jecor/JIXClock/Hardware/1.0rev1/bugs/figure2.jpg

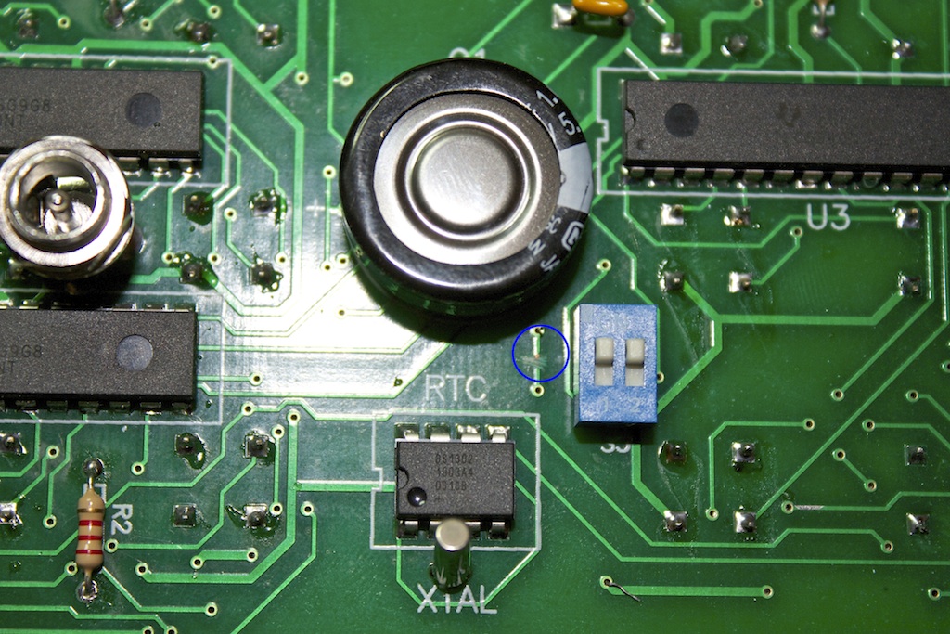
Hardware/1.0rev1/bugs/figure2.jpg
