jecor/JIXClock/Hardware/1.0rev1/bugs/figure3.jpg

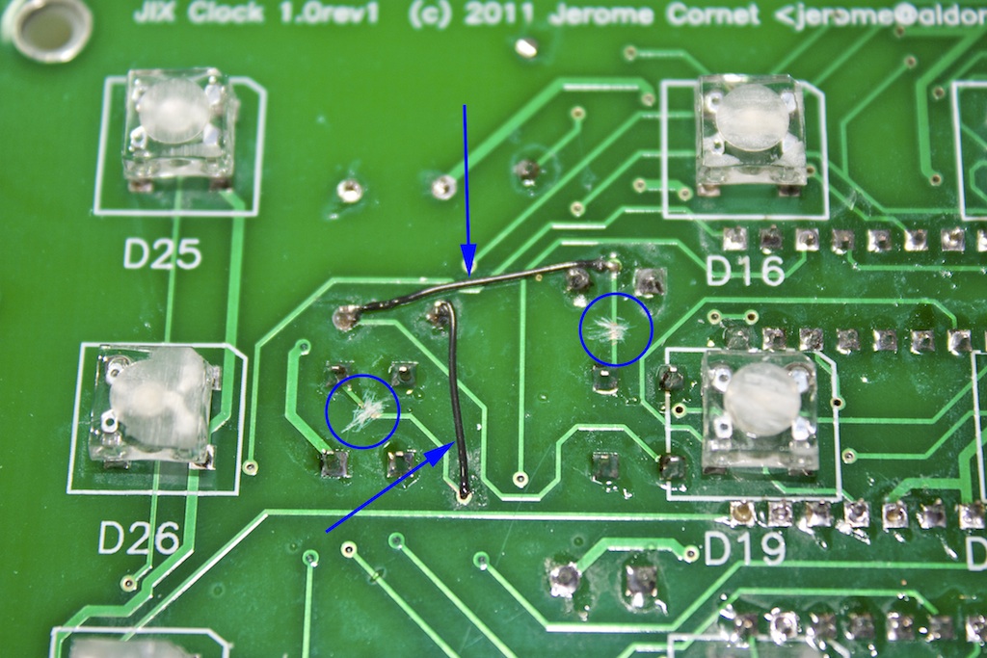
Hardware/1.0rev1/bugs/figure3.jpg
