jecor/JIXClock/README.md

JIXClock
===========

Advanced recreation of the TIX Clock with RGB LEDs, persistent hour and settings, etc.

LICENSE
--------------

* Hardware, Docs and Box under CC-BY-SA.
* Software under GPL v3.

Copyright 2010-2013 Jerome Cornet.
