jecor/JIXClock/Doc/UserGuideFR.pages/QuickLook/Thumbnail.jpg

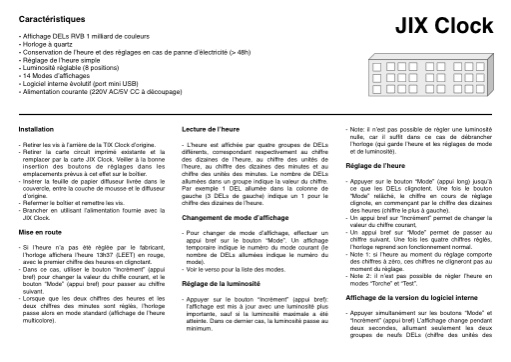
Doc/UserGuideFR.pages/QuickLook/Thumbnail.jpg
