jecor/JIXClock/Hardware/1.0rev1/bugs/figure1.jpg

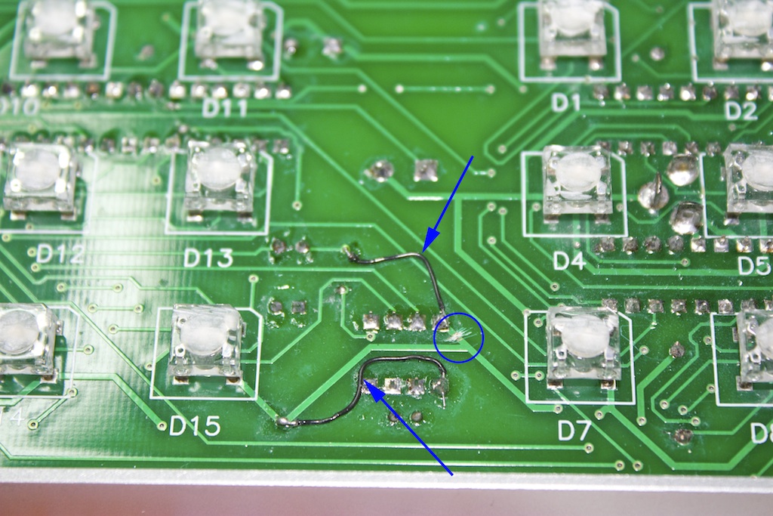
Hardware/1.0rev1/bugs/figure1.jpg
