jecor/JIXClock/Hardware/1.0rev1/schematic/JIXClock.pdf

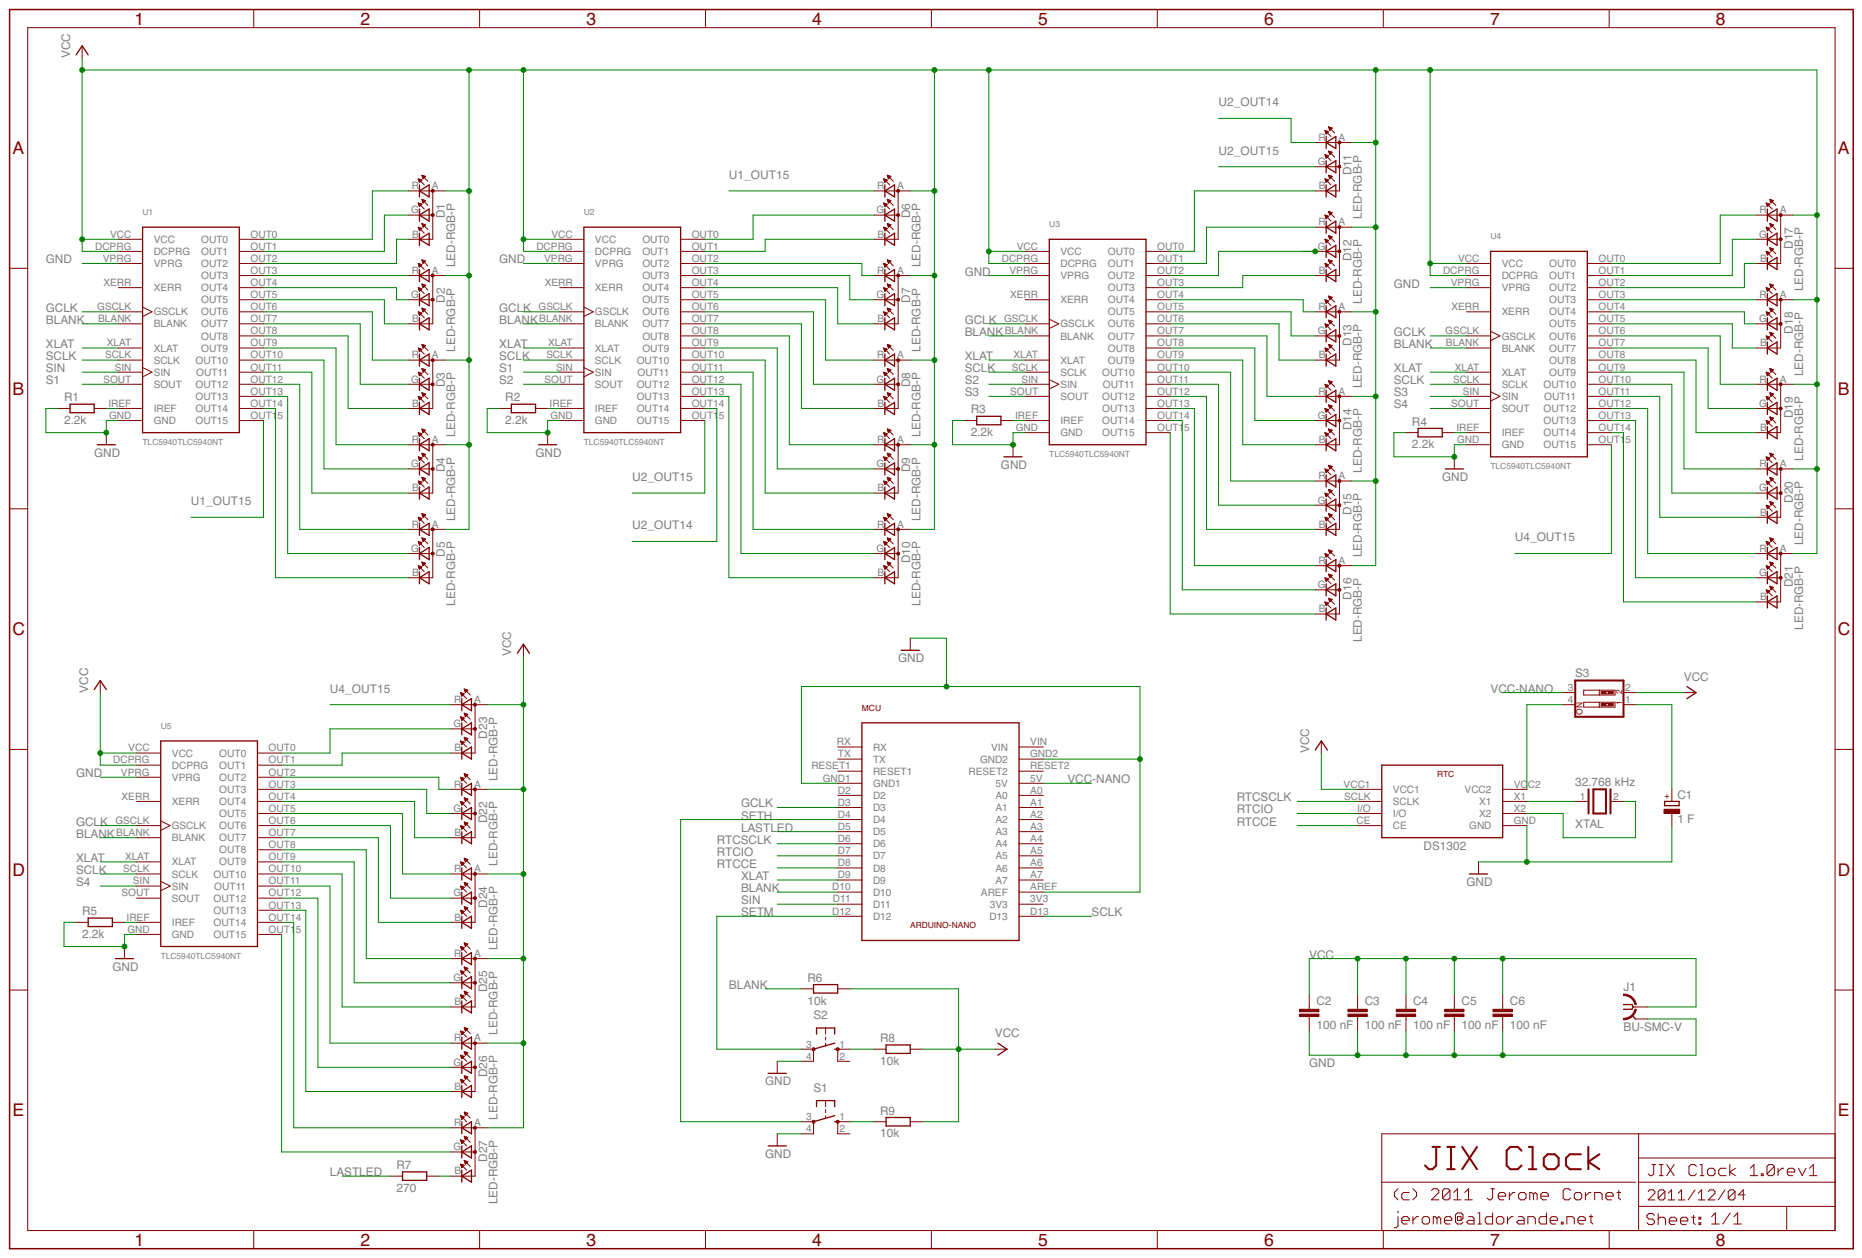
[picture p5: page 1]

LED-RGB-P LED-RGB-P LED-RGB-P

LED-RGB-P LED-RGB-P LED-RGB-P LED-RGB-P LED-RGB-P
