jecor/JIXClock/Box/JIXClockBox-logo.pdf

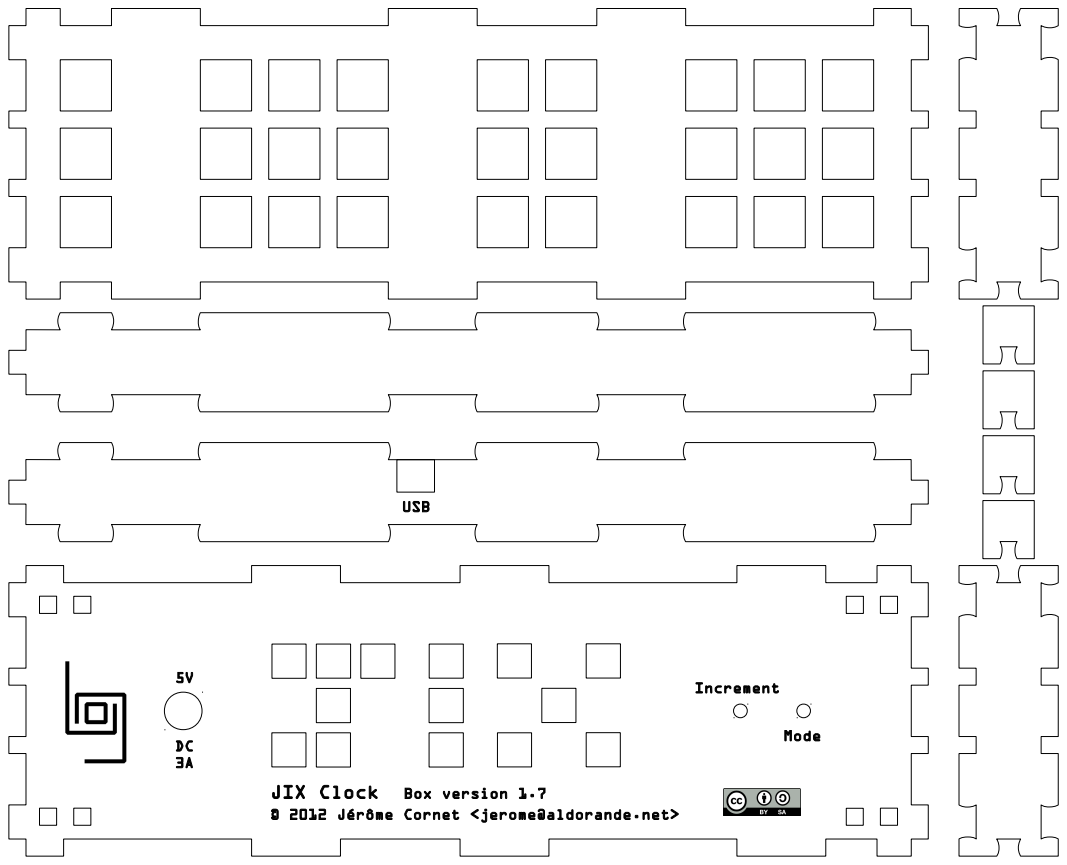
[picture p6: page 1]
JIX Clock; Box version 1.7; Mode; Increment 5V; USB

© 2012 Jérôme Cornet <jerome@aldorande.net>
