jecor/JIXClock/Hardware/1.0rev1/pcb/JIXClockBottom.pdf

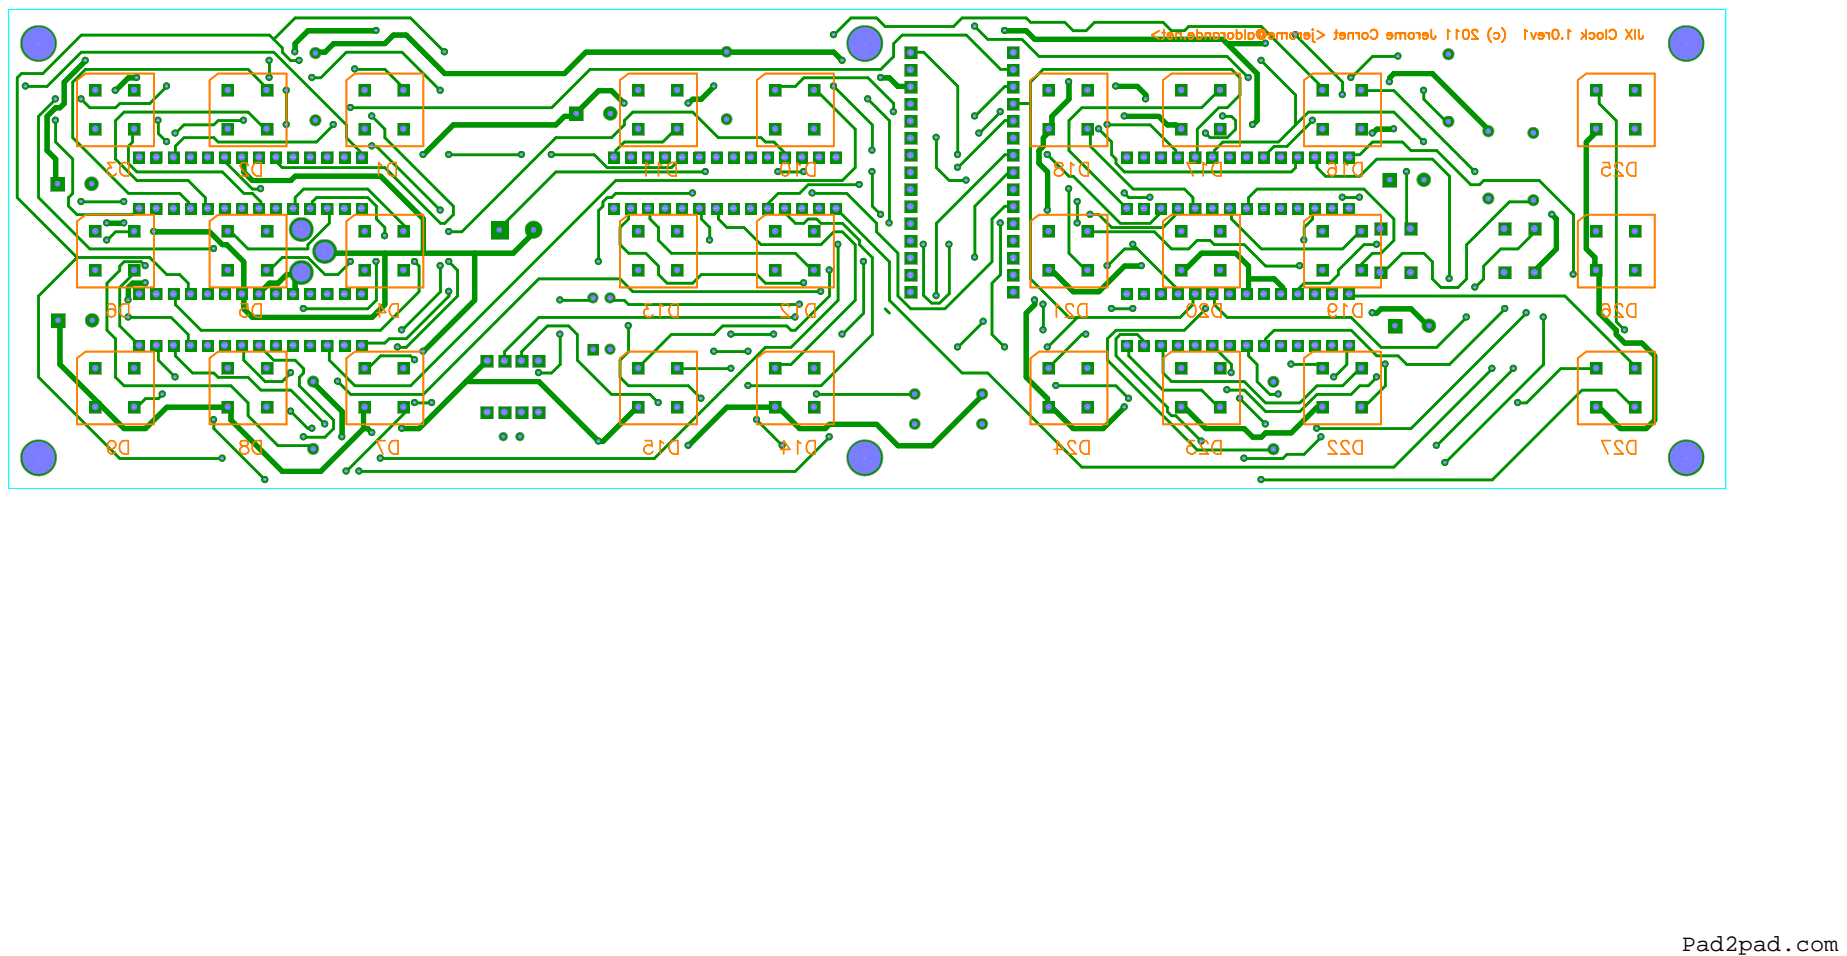
[picture p8: page 1]
