jecor/JIXClock/Hardware/1.0rev1/pcb/JIXClockTop.pdf

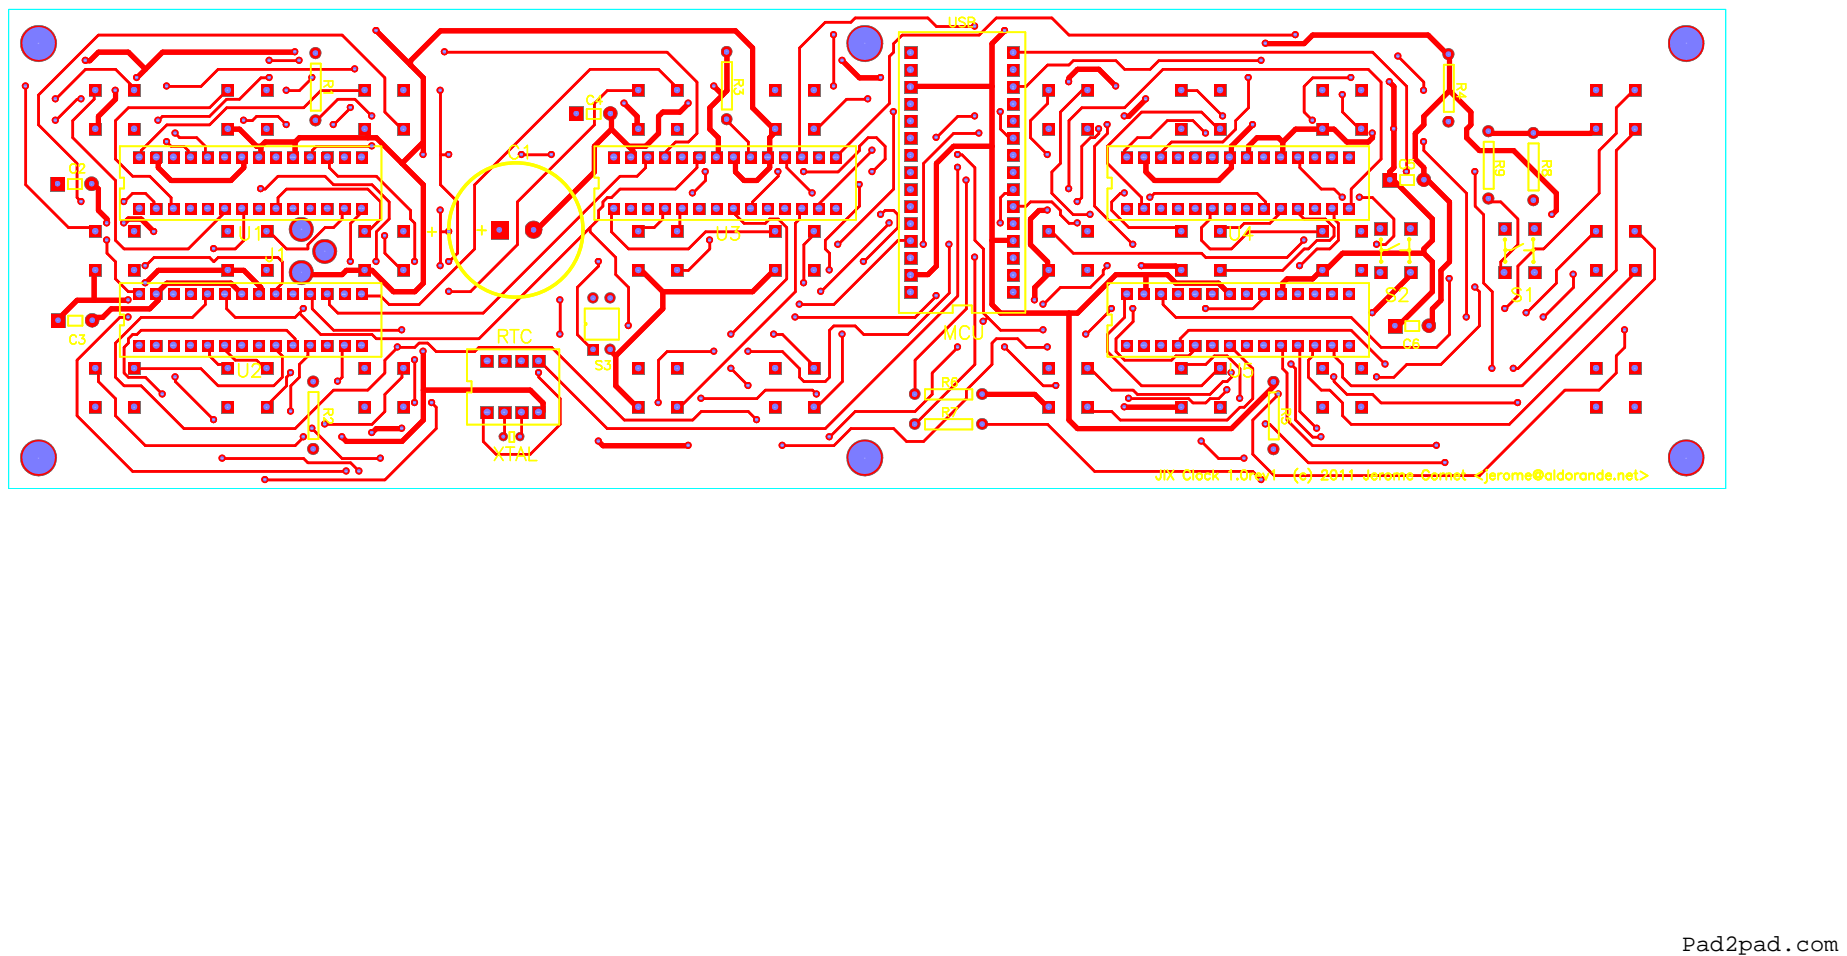
[picture p9: page 1]
