jecor/JIXClock/(list of files, drawings)

Other design files:
Hardware/1.0rev1/pcb/JIXClock.pcb
