jecor/JIXClock/JIXSDK/src/JIXmain.cpp

/*
 * JIXClock SDK
 * Copyright (c) 2012-2013 Jérôme Cornet
 * 
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
 * You should have received a copy of the GNU General Public License
 * along with this program.  If not, see <http://www.gnu.org/licenses/>.
 */

#include <stdio.h>
#include <stdlib.h>
#include <string.h>
#include <time.h>
#include <inttypes.h>
#include <sstream>

#include "SDL.h"
#include "ArduinoCompat.h"
#include "JIXhal.h"
#include "JIXgraphics.h"
#include "JIXrtc.h"
#include "JIXconstants.h"

//-----------------------------------------------------------------
// Global variables
//-----------------------------------------------------------------
extern SDL_Surface  *main_screen;

//-----------------------------------------------------------------
// Prototypes
//-----------------------------------------------------------------
void setup();
void loop();

//-----------------------------------------------------------------
// Implementation
//-----------------------------------------------------------------

int main(int argc, char *argv[])
{
   unsigned int width, height, bpp;
   
   width = 640;
   
   for (int i=1; i<argc; i++)
   {
      std::string currentArg(argv[i]);
   
      if ((currentArg == std::string("-h")) ||
          (currentArg == std::string("--help")))
      {
         std::cout << "usage: " << argv[0] << " [ -options ... ]" << std::endl;
         std::cout << "where options include:" << std::endl << std::endl;
         std::cout << "   -h, --help              display this help message" << std::endl;
         std::cout << "   -w, --width value       set the width of the window (corresponding height is determined automatically)" << std::endl;
         std::cout << "   -at hour minute seconds set the RTC to an artifical time" << std::endl;
         std::cout << std::endl;
         
         return 0;
      }
      else if ((currentArg == std::string("-w")) ||
               (currentArg == std::string("--width")))
      {
         if ((i+1) < argc)
         {
            std::stringstream ss(argv[i+1]);

            ss >> width;            
         }
         else
         {
            std::cerr << "You must provide a value with " << currentArg << " option!" << std::endl;
            return 1;
         }
      }
      else if (currentArg == std::string("-at"))
      {
         if ((i+3) < argc)
         {
            unsigned int h, m, s;
            
            std::stringstream ss(argv[i+1]);
            
            ss >> h;
            
            std::stringstream ss2(argv[i+2]);
            
            ss2 >> m;
            
            std::stringstream ss3(argv[i+3]);
            
            ss3 >> s;
            
            std::cout << "Starting at artificial time " << h << ":" << m << ":" << s << std::endl;
            rtcSetArtificialTime(h, m, s);
         }
         else
         {
            std::cerr << "You must provide three values with " << currentArg << " option!" << std::endl;
            return 1;
         }
      }
   }
   
   Uint32       videoFlags;
         
   if (SDL_Init(SDL_INIT_VIDEO | SDL_INIT_TIMER) < 0)
   {
      fprintf(stderr, "Failed to initialize SDL: %s\n", SDL_GetError());
      exit(1);
   }
   
   height = width / CLOCK_ASPECT_RATIO;
   bpp    = 32;
   videoFlags = SDL_SWSURFACE;

   main_screen = SDL_SetVideoMode(width, height, bpp, videoFlags);
   if (main_screen == NULL)
   {
      fprintf(stderr, "Failed to set video mode: %s\n", SDL_GetError());
      exit(2);
   }
   
   SDL_WM_SetCaption("JIXsimulator", "");
   
   rtcLoadMemory(memoryFileName);
   
   drawBackground(main_screen);
   drawLEDs(main_screen);
   
   setup();
   loop();
   
   return 0;
}
