jecor/JIXClock/JIXos/JIXStandardConstants.h

//----------------------------------------------------------------------------------------
// JIXos: JIX Clock operating system
// Copyright (c) 2010-2013 Jérôme Cornet <jerome@aldorande.net>
// 
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
//----------------------------------------------------------------------------------------
// Standard Mode with Tetris-like display - constants
//----------------------------------------------------------------------------------------
#ifndef JIX_STANDARD_CONSTANTS_H
#define JIX_STANDARD_CONSTANTS_H

#include <Arduino.h>

//----------------------------------------------------------------------------------------
// Constants for 3 LEDs displays
//----------------------------------------------------------------------------------------

const unsigned int standardThreesSize  = 3;

//----------------------------------------------------------------------------------------
const uint8_t standardThreesNbPieces0 = 1;

const prog_uint8_t standardThrees0[standardThreesNbPieces0 * standardThreesSize] PROGMEM = 
            { 0,
              0,
              0,  
            };

//----------------------------------------------------------------------------------------
const uint8_t standardThreesNbPieces1 = 3;

const prog_uint8_t standardThrees1[standardThreesNbPieces1 * standardThreesSize] PROGMEM = 
            { 1,
              0,
              0,
            
              0,
              1,
              0,
            
              0,
              0,
              1  
            };
            
//----------------------------------------------------------------------------------------
const uint8_t standardThreesNbPieces2 = 2;

const prog_uint8_t standardThrees2[standardThreesNbPieces2 * standardThreesSize] PROGMEM = 
            { 1,
              1,
              0,
            
              0,
              1,
              1  
            };

//----------------------------------------------------------------------------------------
static const uint8_t * standardThrees[3] = { (const uint8_t *)standardThrees0, 
                                             (const uint8_t *)standardThrees1, 
                                             (const uint8_t *)standardThrees2
                                           };
                                 
const uint8_t standardThreesNbPieces[3] = { standardThreesNbPieces0,
                                            standardThreesNbPieces1,
                                            standardThreesNbPieces2
                                          };

//----------------------------------------------------------------------------------------
// Constants for 6 LEDs displays
//----------------------------------------------------------------------------------------

const unsigned int standardSixSize  = 6;

//----------------------------------------------------------------------------------------
const uint8_t standardSixNbPieces0 = 1;

const prog_uint8_t standardSix0[standardSixNbPieces0 * standardSixSize] PROGMEM = 
            { 0, 0,
              0, 0,
              0, 0 
            };

//----------------------------------------------------------------------------------------
const uint8_t standardSixNbPieces1 = 6;

const prog_uint8_t standardSix1[standardSixNbPieces1 * standardSixSize] PROGMEM = 
            { 1, 0,
              0, 0,
              0, 0,
            
              0, 0,
              1, 0,
              0, 0,
            
              0, 0,
              0, 0,
              1, 0,
            
              0, 1,
              0, 0,
              0, 0, 
            
              0, 0,
              0, 1,
              0, 0, 
            
              0, 0,
              0, 0,
              0, 1  
            };
            
//----------------------------------------------------------------------------------------
const uint8_t standardSixNbPieces2 = 9;

const prog_uint8_t standardSix2[standardSixNbPieces2 * standardSixSize] PROGMEM = 
            { 1, 1,
              0, 0,
              0, 0,
              
              0, 0,
              1, 1,
              0, 0,
              
              0, 0,
              0, 0,
              1, 1,
              
              1, 0,
              1, 0,
              0, 0,
              
              0, 1,
              0, 1,
              0, 0,
              
              0, 0,
              1, 0,
              1, 0,
              
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
              1, 1, 1,
              
              1, 1, 1,
              1, 0, 1,
              1, 1, 1,
              
              1, 1, 1,
              1, 1, 1,
              0, 1, 1,
              
              1, 1, 1,
              1, 1, 1,
              1, 1, 0  
            };

//----------------------------------------------------------------------------------------
const uint8_t standardNinesNbPieces9 = 1;

const prog_uint8_t standardNines9[standardNinesNbPieces9 * standardNinesSize] PROGMEM = 
            { 1, 1, 1,
              1, 1, 1,
              1, 1, 1  
            };                                 

//----------------------------------------------------------------------------------------
static const uint8_t * standardNines[10] = { (const uint8_t *)standardNines0, 
                                             (const uint8_t *)standardNines1, 
                                             (const uint8_t *)standardNines2, 
                                             (const uint8_t *)standardNines3, 
                                             (const uint8_t *)standardNines4, 
                                             (const uint8_t *)standardNines5, 
                                             (const uint8_t *)standardNines6,
                                             (const uint8_t *)standardNines7,
                                             (const uint8_t *)standardNines8,
                                             (const uint8_t *)standardNines9 
                                           };

const uint8_t standardNinesNbPieces[10] = { standardNinesNbPieces0,
                                            standardNinesNbPieces1,
                                            standardNinesNbPieces2,
                                            standardNinesNbPieces3,
                                            standardNinesNbPieces4,
                                            standardNinesNbPieces5,
                                            standardNinesNbPieces6,
                                            standardNinesNbPieces7,
                                            standardNinesNbPieces8,
                                            standardNinesNbPieces9,
                                          };

//----------------------------------------------------------------------------------------
// Color related constants
//----------------------------------------------------------------------------------------

const uint8_t standardColorDifference = 4;

#endif
