jecor/JIXClock/(commit log)

2012-01-05 Initial import for public release
    [JIXClock.pcb, JIXClock.sch]
2012-01-05 Update to be compatible with new Arduino IDE 1.0
2012-01-05 Renamed files using new Arduino 1.0 convention (.ino instead of .pde)
2012-02-23 Improved preprocessor and build process to generate single .cpp file (as Arduino), with #line directives
2012-02-23 Fixed compile time warnings
    [JIXRainbowMode.ino, JIXSplash.ino]
2012-03-22 Created abstraction layer for buttons, implemented button support in SDK simulator
2012-03-22 Added missing files for button support
    [JIXButtons.ino, JIXbuttons.cpp]
2012-03-22 Added missing header (for portability)
    [JIXhal.h]
2012-03-22 Fixed huge bug in led array indexing
    [JIXgraphics.cpp]
2012-03-22 Fixed another instance of LED number bug
    [JIXgraphics.cpp]
2012-06-27 Rajout d'une ligne de guidage
2012-06-28 Fixed size of box, began piece to fix pcb
2012-07-10 Fixed size of supply hole, fixed alignment of buttons holes
2012-07-10 Fixed depth of the box (+4mm)
2012-07-11 Fixed front holes position accuracy
2012-07-11 Fixed bug in back introduced by holes position fix
2012-07-11 Added USB hole
2012-07-13 Fixed USB hole, height of "cales"
2012-08-02 Version 1.3, increased size of copyright text to avoid laser cut of it
2012-09-05 Version 1.5, restored normal width to creneaux, added curves to fix assembly
2012-10-04 Fixed location of supply/buttons so that LEDS get aligned correctly with holes
2012-10-07 Fixed unaligned USB hole (due to moved supply and buttons)
2013-04-15 Added missing part for led masking
2013-11-11 Fixed wrong case in file name preventing proper compilation under Linux
    [JIXgraphics.cpp]
2013-11-21 Solved "constants not found" error by creating a separate file for them, with appropriate qualifier on non-PROGMEM constants.
    [JIXColorfulMode.cpp, JIXRainbowMode.cpp, JIXSecondsBlinkMode.cpp, JIXSecondsMode.cpp, JIXStandardConstants.h, JIXStandardMode.cpp]
2013-11-21 Migrated JIXsdk Makefile to new .h/.cpp files
    The only file to be preprocessed using ino_preprocess is the main (and only) .ino file.
    Other files are compiled as regular c++ files, except special include directives.
    JIXos cpp files have a dedicated .deps_ino and .objs_ino dependency/object directories.
    In addition, it is now necessary to have placeholder include files for Arduino.h and Tlc5940.h.
2013-11-21 Added separate constant file to fix compile warning on memoryFileName
    [JIXconstants.h, JIXmain.cpp, JIXtimer.cpp]
2013-11-21 Added comments to separate global variables, prototypes, etc.
2013-11-22 Introduced missing prototypes in .ino as well to avoid relying on Arduino prototype generator
    [JIXos.ino]
2013-11-23 Fixed wrong prototypes for rtcGetMemory() and rtcSetMemory()
    The link was failing with recent clang due to this.
    [JIXrtc.cpp]
2013-11-23 Preliminary clean-up, now compiling .ino file directly
    The clean-up consisted in removing unused variables, renaming variables to get
    clearer view of who is doing what.
    The change also introduce experimental compilation of .ino without doing a
    prototype generation first.
2013-11-23 Removed dependency on Java by removing the prototype generation stage
    This generation stage is no longer needed, because the JIXos code actually
    always declares the prototypes, and all files but the main .ino are compiled
    as pure c++ by the Arduino IDE itself.
2013-11-23 Updated release notes (as we no longer use prototype generation at all)
2013-11-23 Fixed bug when printing new mode on the serial console
    [JIXos.ino]
2013-11-23 Fixed simulator black LEDs in Torch mode
    The original assumption of storing LEDs values with 10-bit range is no longer valid (see
    ledsHSDLToRGB() which returns 8-bit values). The comment of the function is therefore wrong.
    In addition, we put a special trick to get a "nice" display for Torch mode or pure gray
    colors.
    [JIXgraphics.cpp]
2013-11-23 Fixed cosmetic problem with "Seconds" modes and Torch mode by doing gamma correction
    Even with previous commit, the Torch mode was difficult to see for low luminosity values.
    "Seconds" modes make usage of low luminosity values and are also affected.
    The solution is to apply a gamma correction of 5, resulting in a steep curve right from
    low values (almost an offset in practice), and better visibility of luminosity changes.
    [JIXgraphics.cpp]
